SatcomRadio/QCN3-Board/README.md

# QCN3-Board

PCB board for the hybrid coupler QCN3

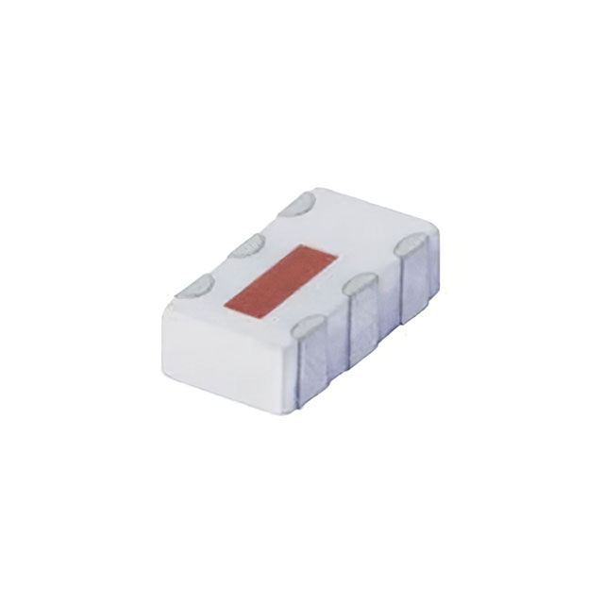
[picture p1: img/qcn3.jpg]
QCN3


## Warning, maximum transmission power (datasheet) is 15W. But it's better to not go over 5-10W

<p float="left">
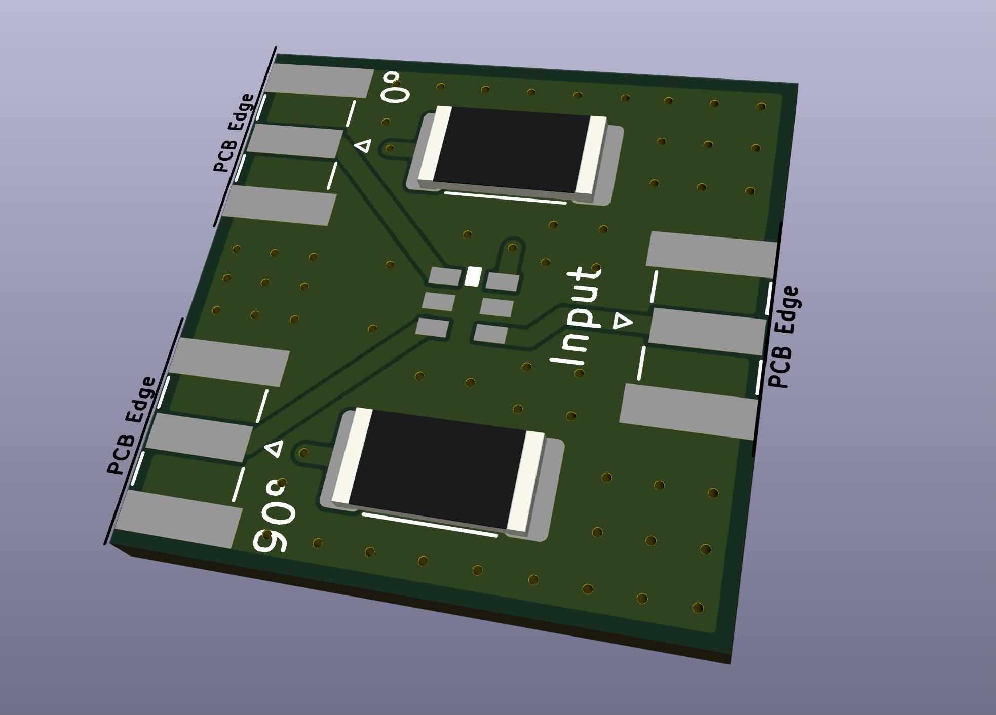
[picture p2: img/board.png]
QCN3 Board
	
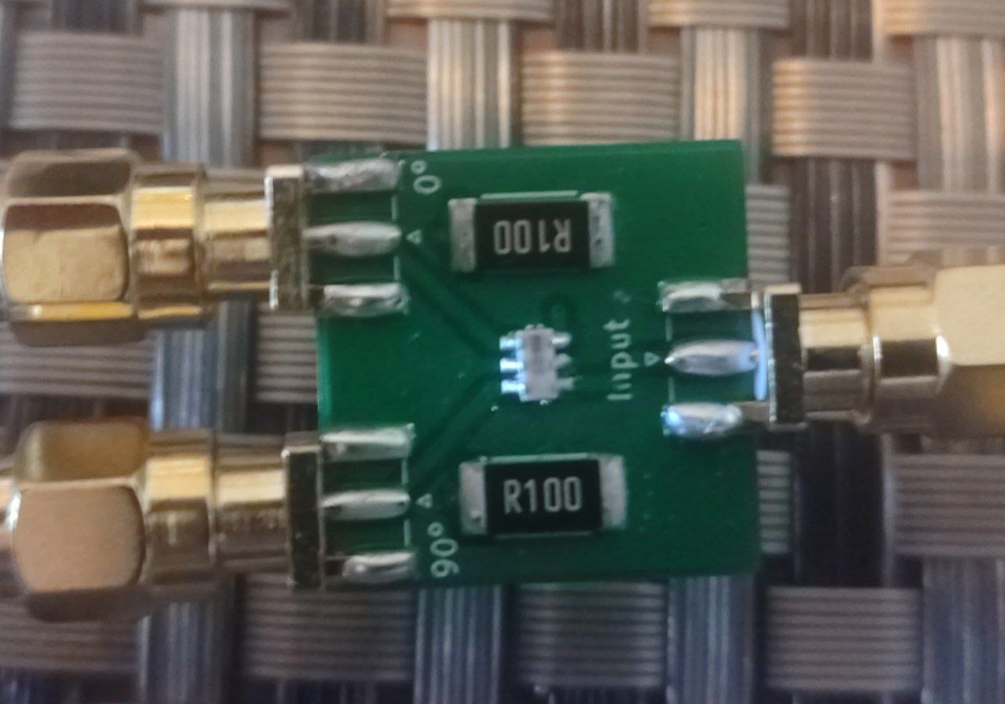
[picture p3: img/FinishedBoard.jpg]
QCN3 Final board
	
</p>

It allows to do the right hand circular polarization without having to deal with coax cables.  

------

Nano VNA results (with 2 50 ohms loads at the outputs)

<p float="left">
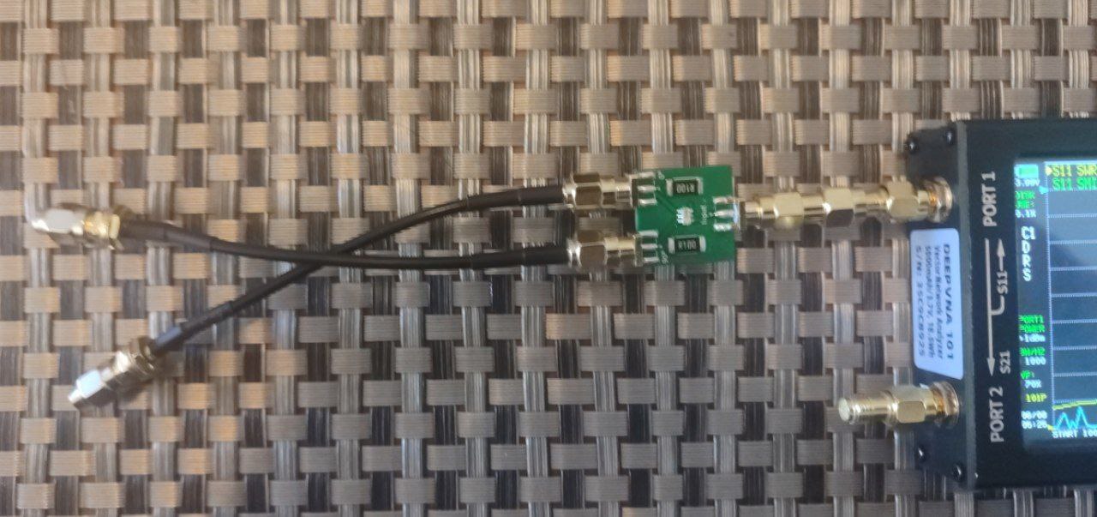
[picture p4: img/BoardTesting.jpg]
QCN3 Board test setup
	
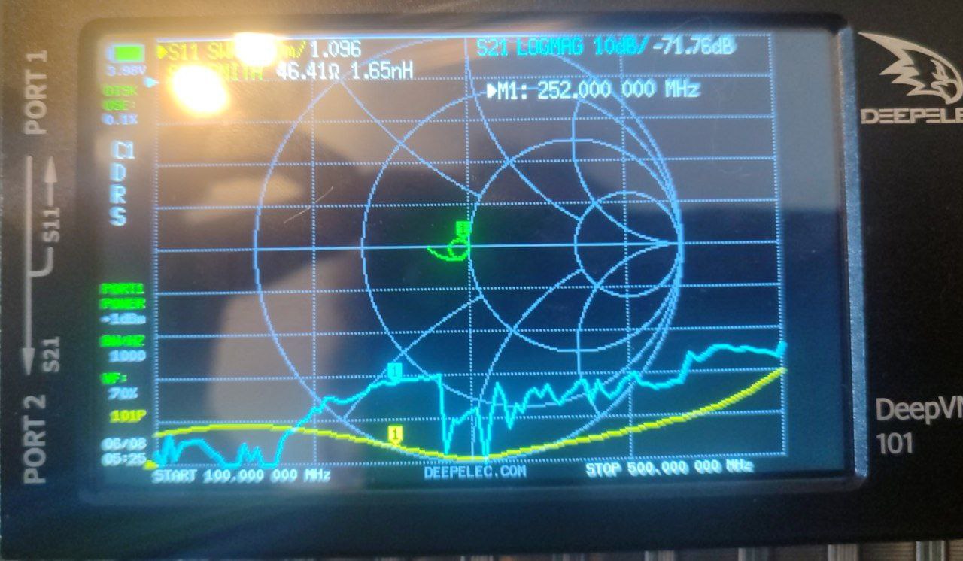
[picture p5: img/NanoVna.jpg]
QCN3 Board results with nanovna
	
</p>

------

Connect the 90º pin to the right of the 0º pin to allow **right hand circular polarization**.  
Make sure that the 2 output wires have the same length!

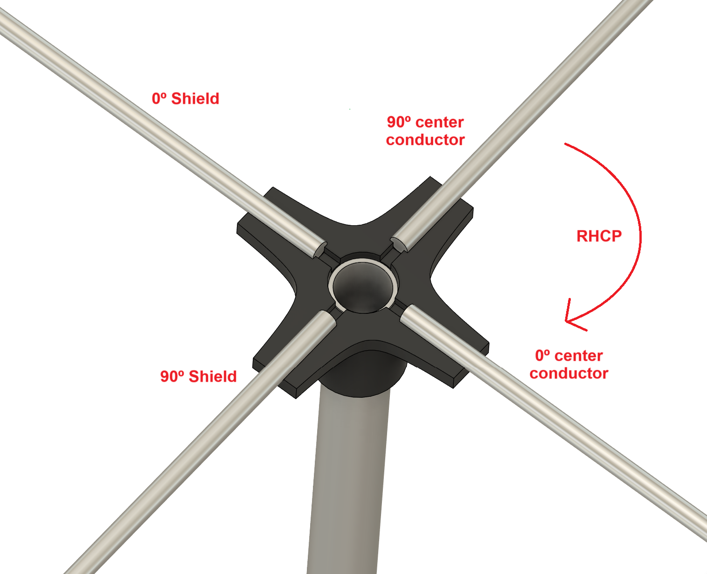
[picture p6: img/Connection.png]
Board pinout


------

You can order it at jlcpcb or other companies using the gerber zip file in this repository.  
Make sure to order it with 1.6 board width  

------

BOM:

- 1x QCN-3
- 2x SMD resistor 2512 100Ω 2W
- 3x SMA connectors for PCB with 1.6mm spacing

<p float="left">
	QCN3
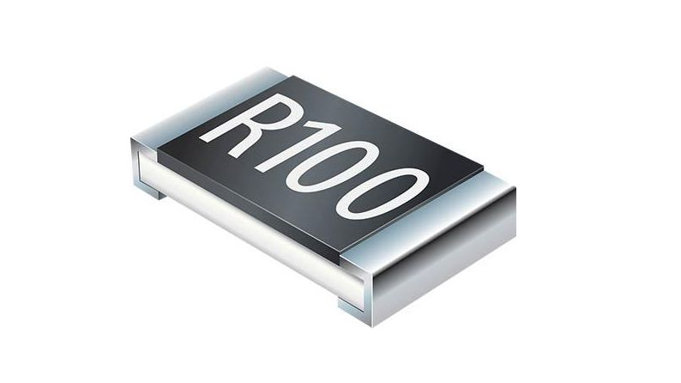
[picture p7: img/resistor.png]
SMD resistor
	
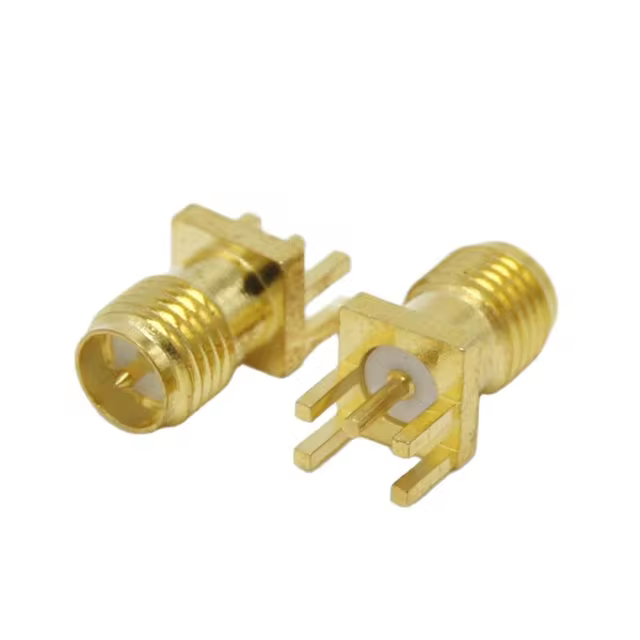
[picture p8: img/sma.png]
SMA connectors
	
</p>
