SatcomRadio/QCN3-Board/Kicad/Qcn3AntennaBoard.kicad_pcb

## KiCad design Kicad/Qcn3AntennaBoard.kicad_pcb (2024-10-04)

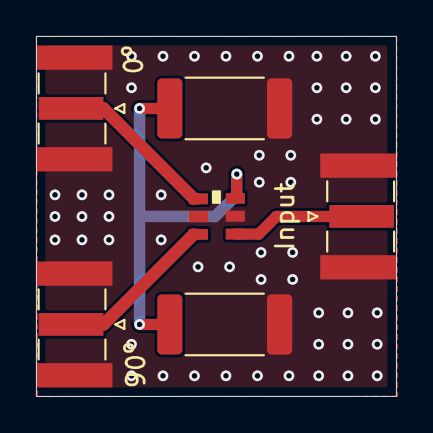
[picture p9: board Qcn3AntennaBoard.kicad_pcb from above]

Board: 2 copper layers, 20.0 x 20.0 mm, 6 parts (0 on the bottom side), 5 nets.

Parts:
0º, 90º: Conn_Coaxial_Small; SMA_Samtec_SMA-J-P-X-ST-EM1_EdgeMount
Input: Conn_Coaxial_Small; SMA_Samtec_SMA-J-P-X-ST-EM1_EdgeMount
R1, R2: 100; R_2512_6332Metric_Pad1.40x3.35mm_HandSolder
U1: QCN3

Connections:
GND: 0º.2 (Ext), 90º.2 (Ext), Input.2 (Ext), R1.2, R2.2, U1.2 (GND), U1.5 (GND)
unnamed: 0º.1 (In), U1.4 (P1)
unnamed: 90º.1 (In), U1.6 (P2)
unnamed: Input.1 (In), U1.1 (SUM)
unnamed: R1.1, R2.1, U1.3 (50_OHM)
